armarten/hmc-cowBell-clinic/custom_emitter_team/matlab_data/arduino_plot_figs/03-24_coolterm_parallel_alicat_scatter_error_compare_fig_52.png

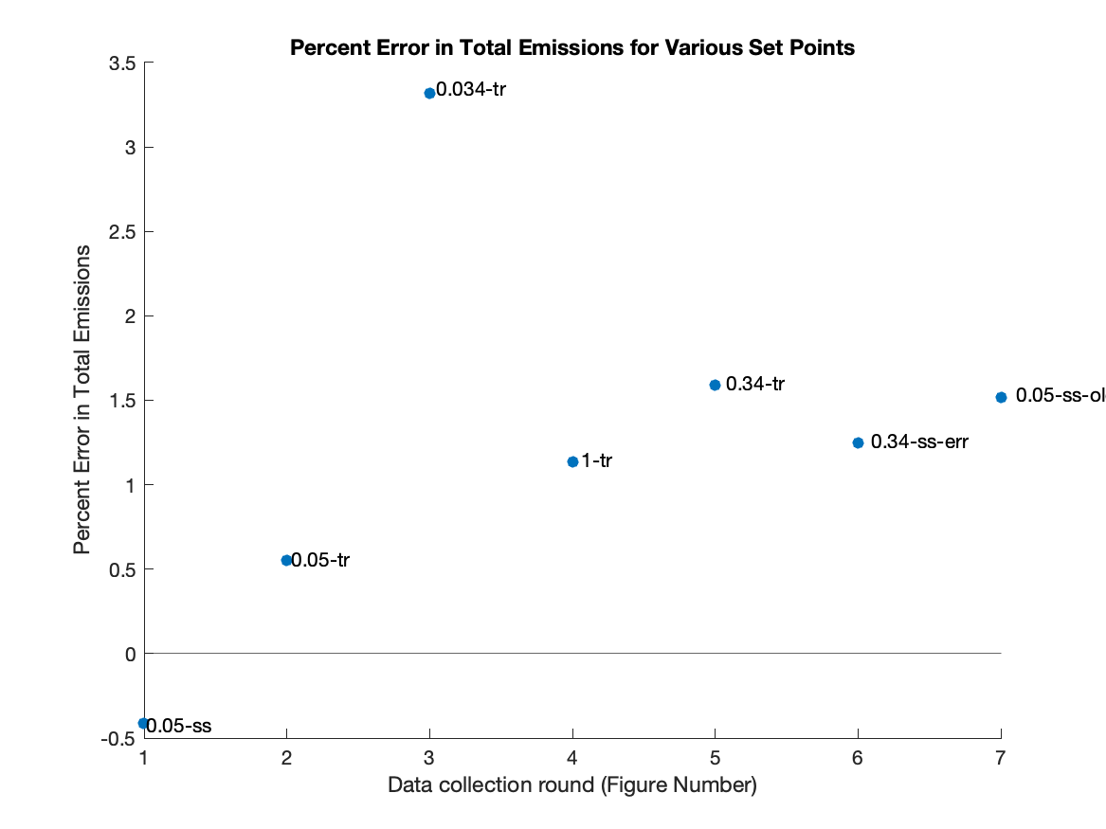
custom_emitter_team/matlab_data/arduino_plot_figs/03-24_coolterm_parallel_alicat_scatter_error_compare_fig_52.png
