armarten/hmc-cowBell-clinic/custom_emitter_team/matlab_data/arduino_plot_figs/04-23_cal_sensirion_leak.png

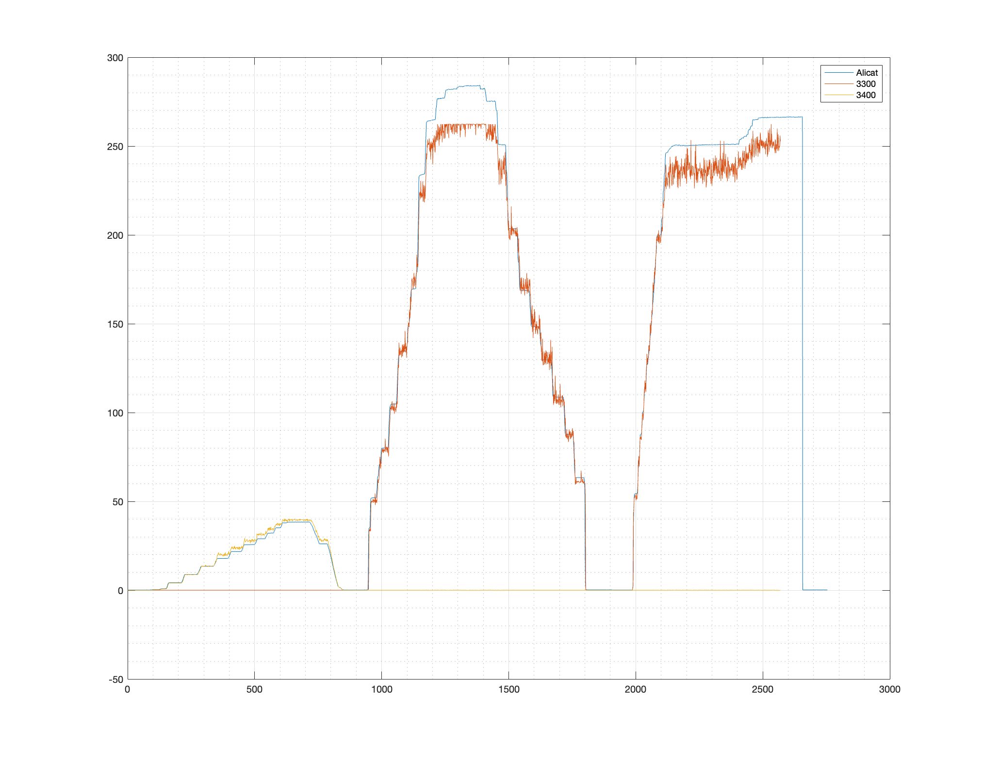
custom_emitter_team/matlab_data/arduino_plot_figs/04-23_cal_sensirion_leak.png
