armarten/hmc-cowBell-clinic/custom_emitter_team/matlab_data/arduino_plot_figs/07-Feb-2024-13-24-22_ppp_sweepppp_sweep_fig_30.png

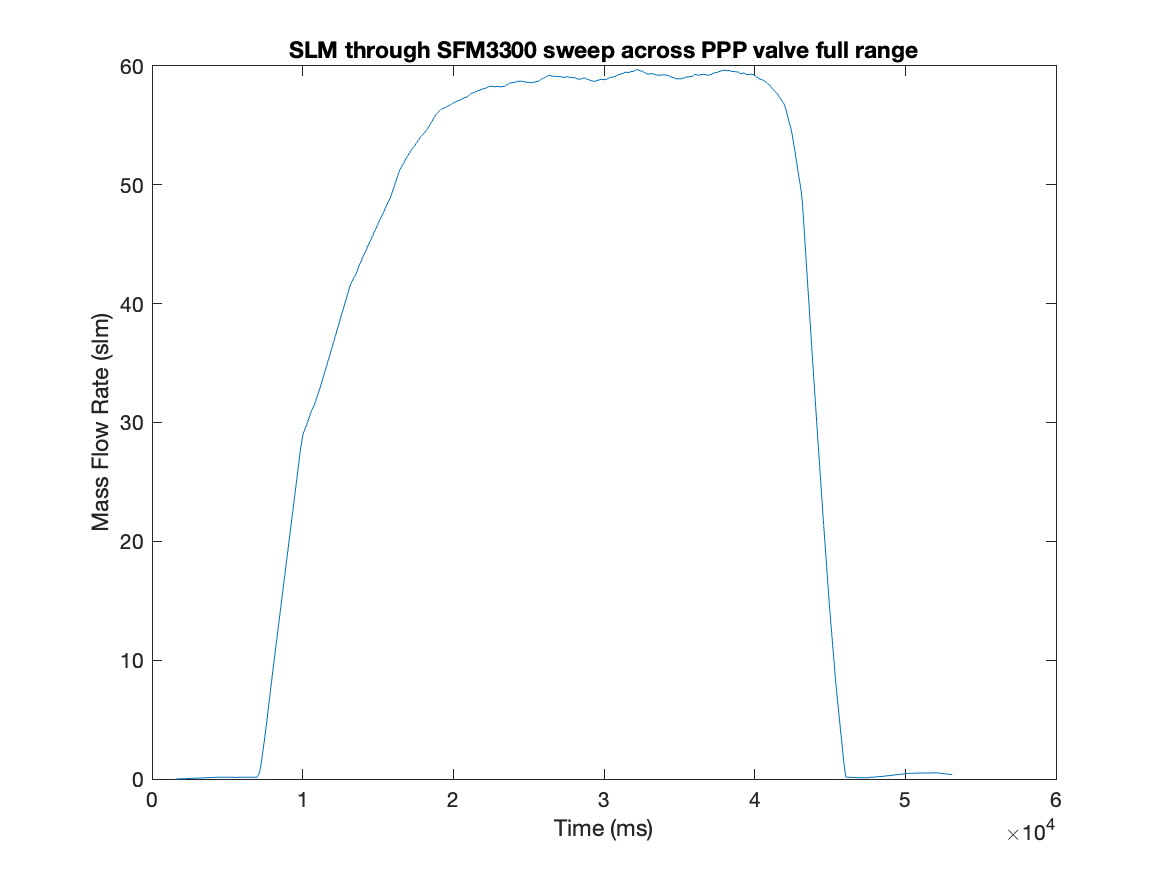
custom_emitter_team/matlab_data/arduino_plot_figs/07-Feb-2024-13-24-22_ppp_sweepppp_sweep_fig_30.png
