armarten/hmc-cowBell-clinic/custom_emitter_team/matlab_data/arduino_plot_figs/all_mag_poster.png

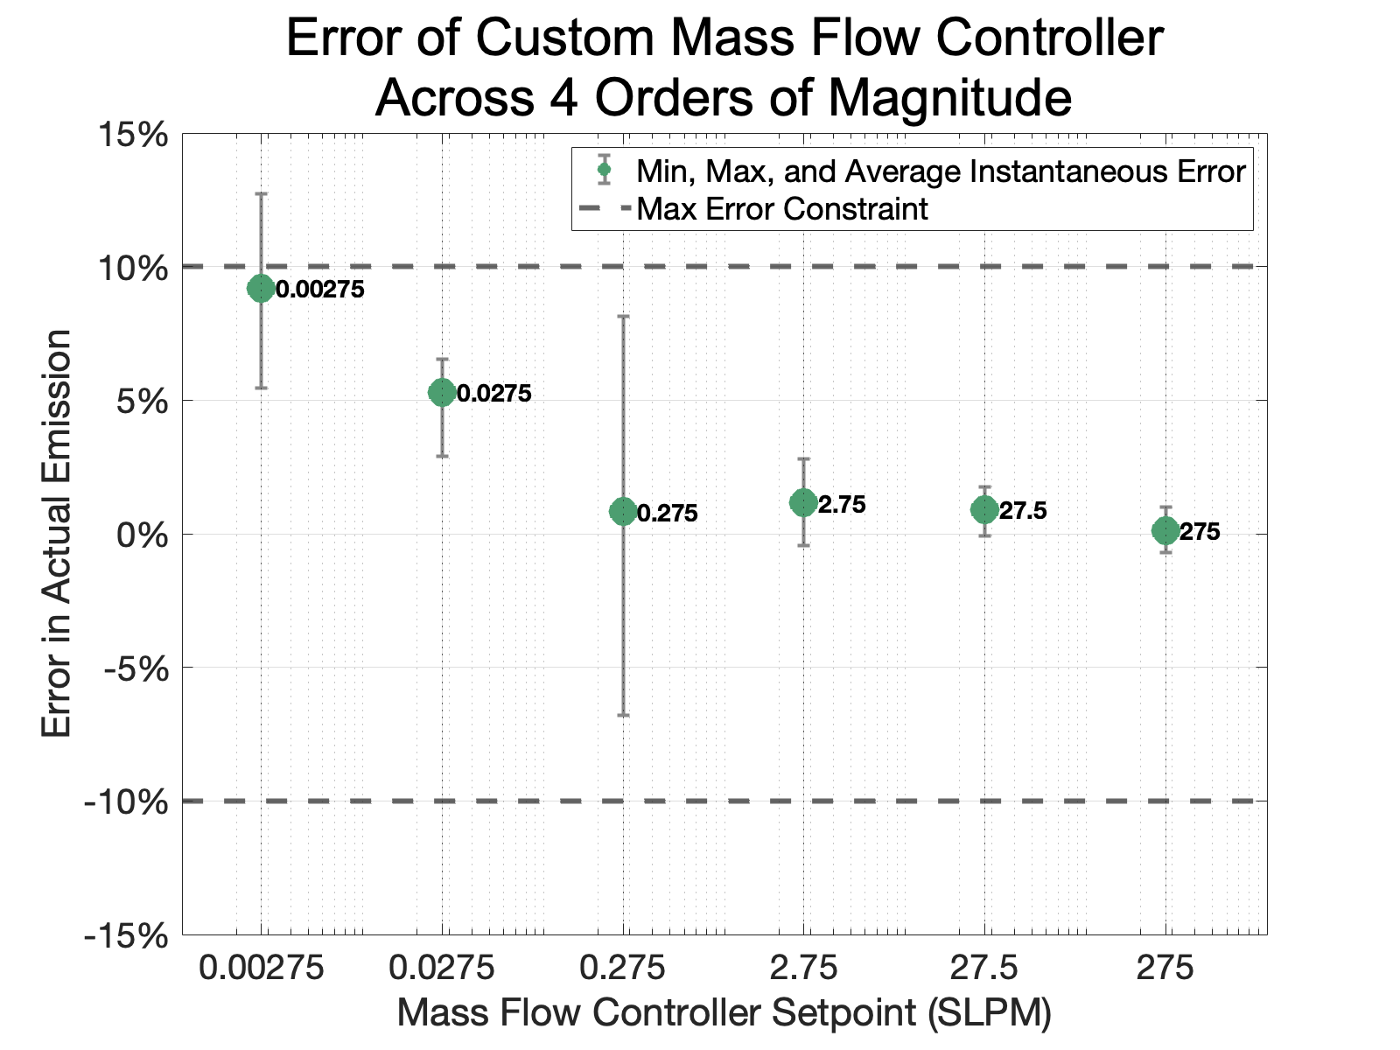
custom_emitter_team/matlab_data/arduino_plot_figs/all_mag_poster.png
