armarten/hmc-cowBell-clinic/custom_emitter_team/matlab_data/arduino_plot_figs/all_magnitudes_final_presentation.png

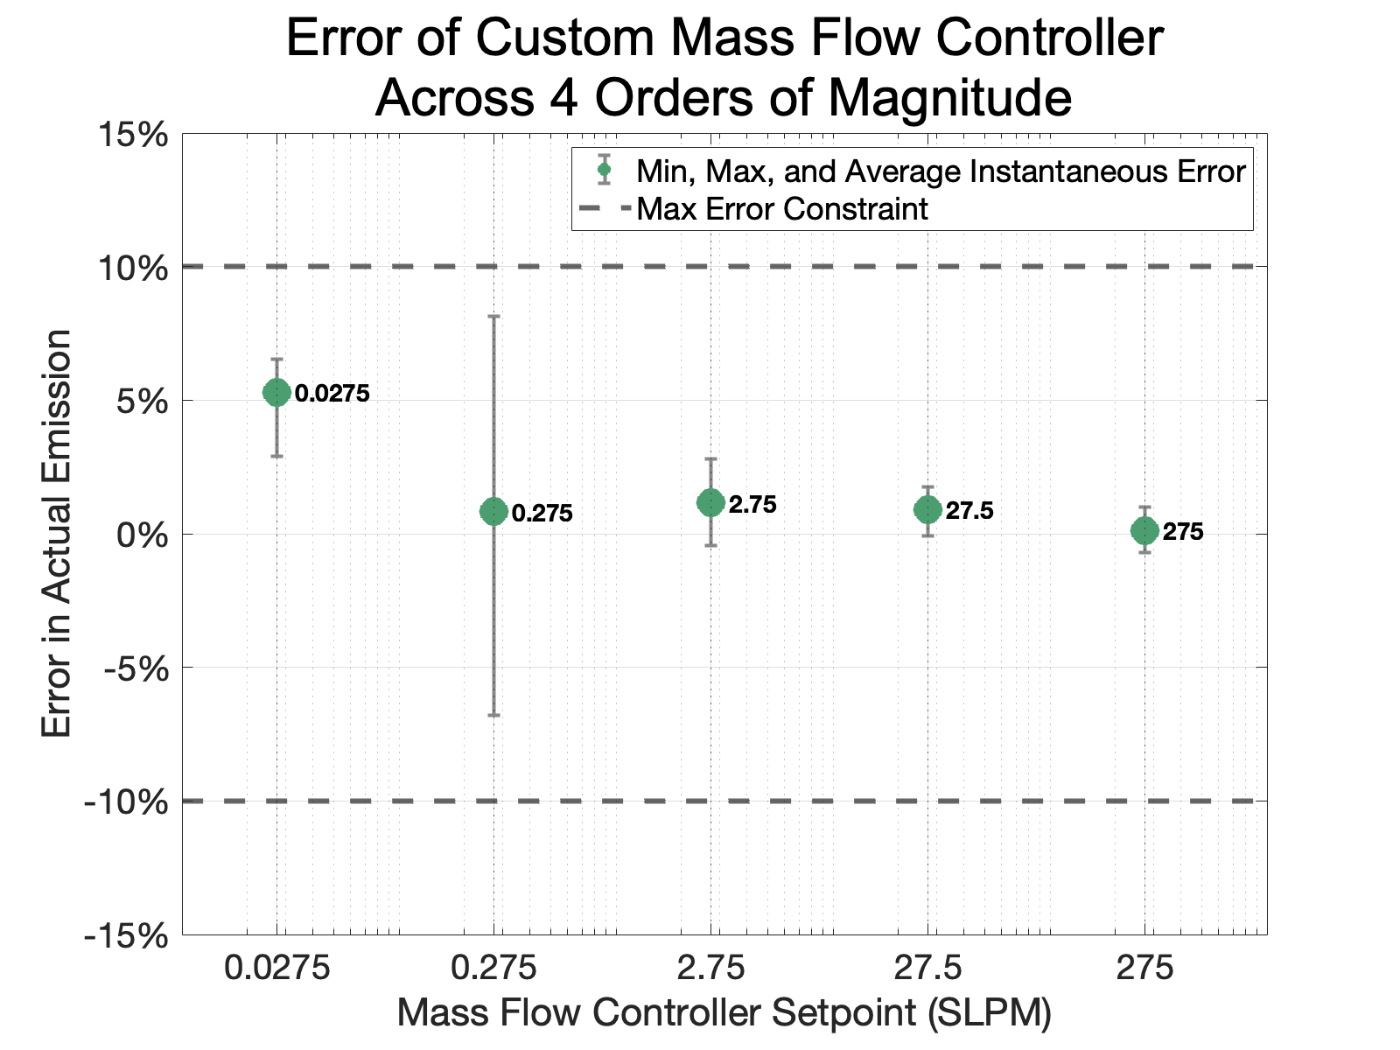
custom_emitter_team/matlab_data/arduino_plot_figs/all_magnitudes_final_presentation.png
