armarten/hmc-cowBell-clinic/custom_emitter_team/matlab_data/arduino_plot_figs/error_bars.png

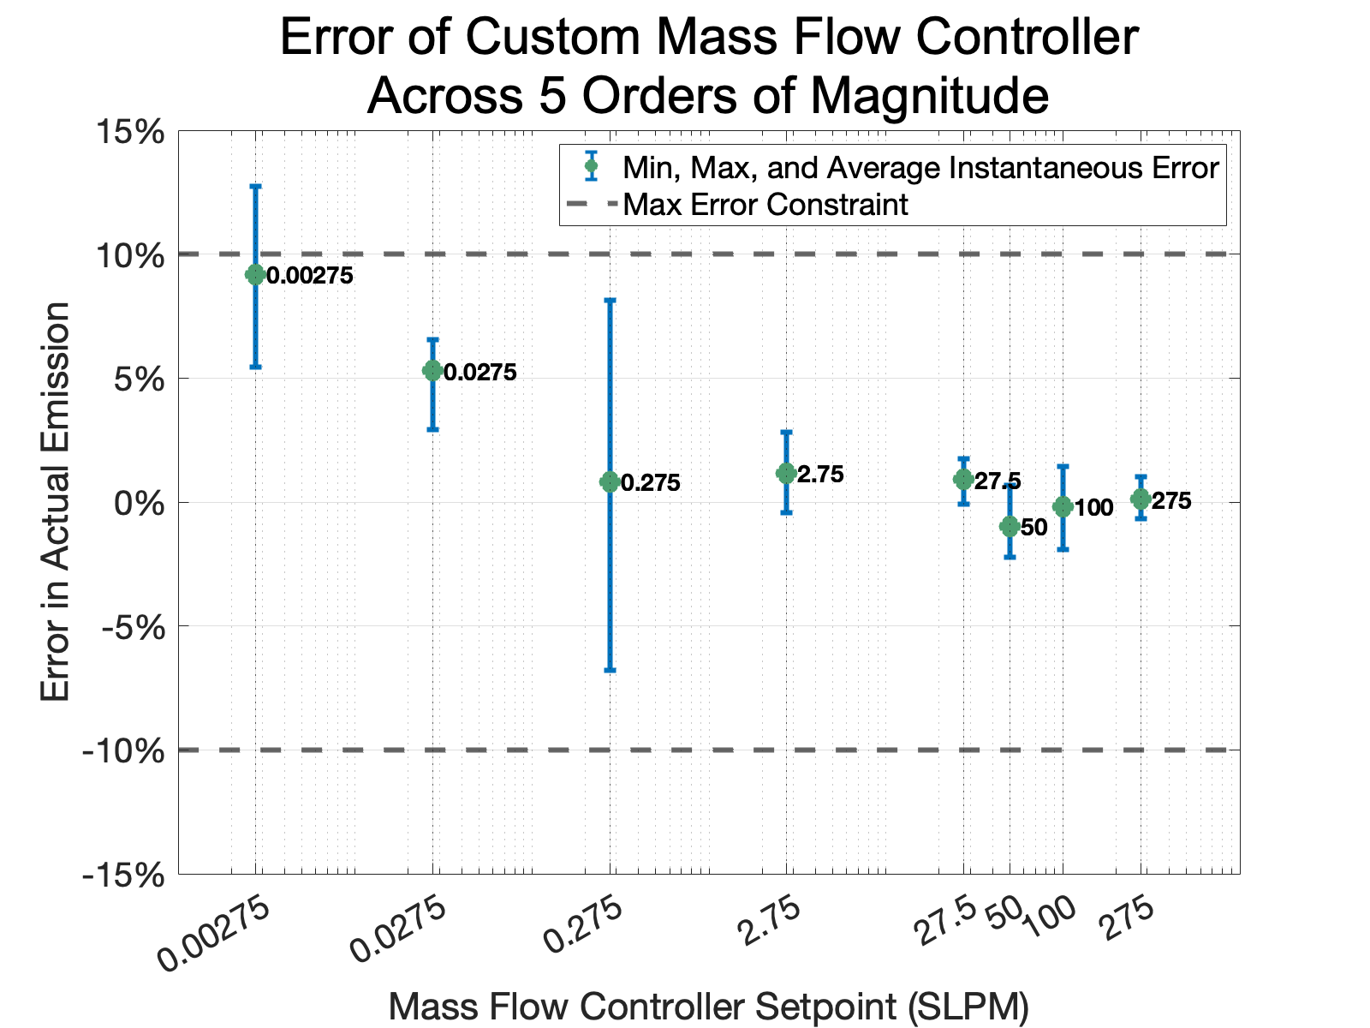
custom_emitter_team/matlab_data/arduino_plot_figs/error_bars.png
