armarten/hmc-cowBell-clinic/custom_emitter_team/matlab_data/arduino_plot_figs/investigate_100_260_offsets.png

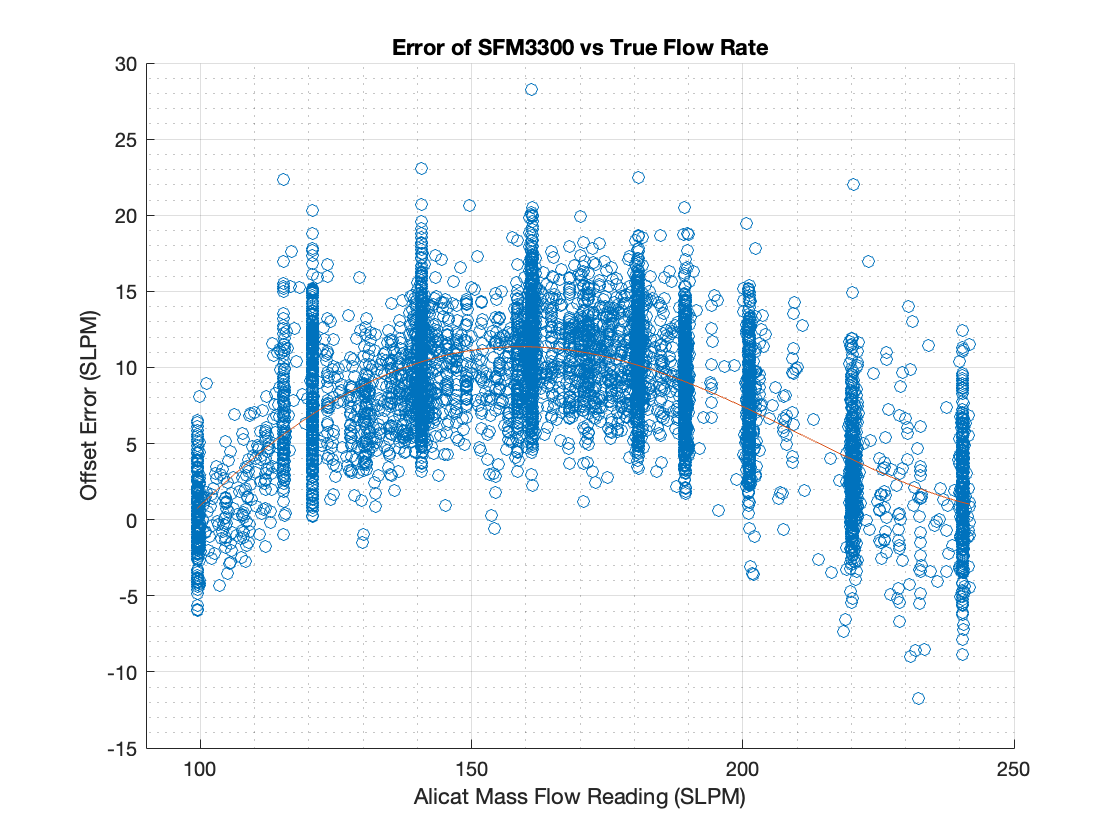
custom_emitter_team/matlab_data/arduino_plot_figs/investigate_100_260_offsets.png
