armarten/hmc-cowBell-clinic/custom_emitter_team/matlab_data/arduino_plot_figs/p control 3400 2_12_2024 - Sheet 4__fig_30.png

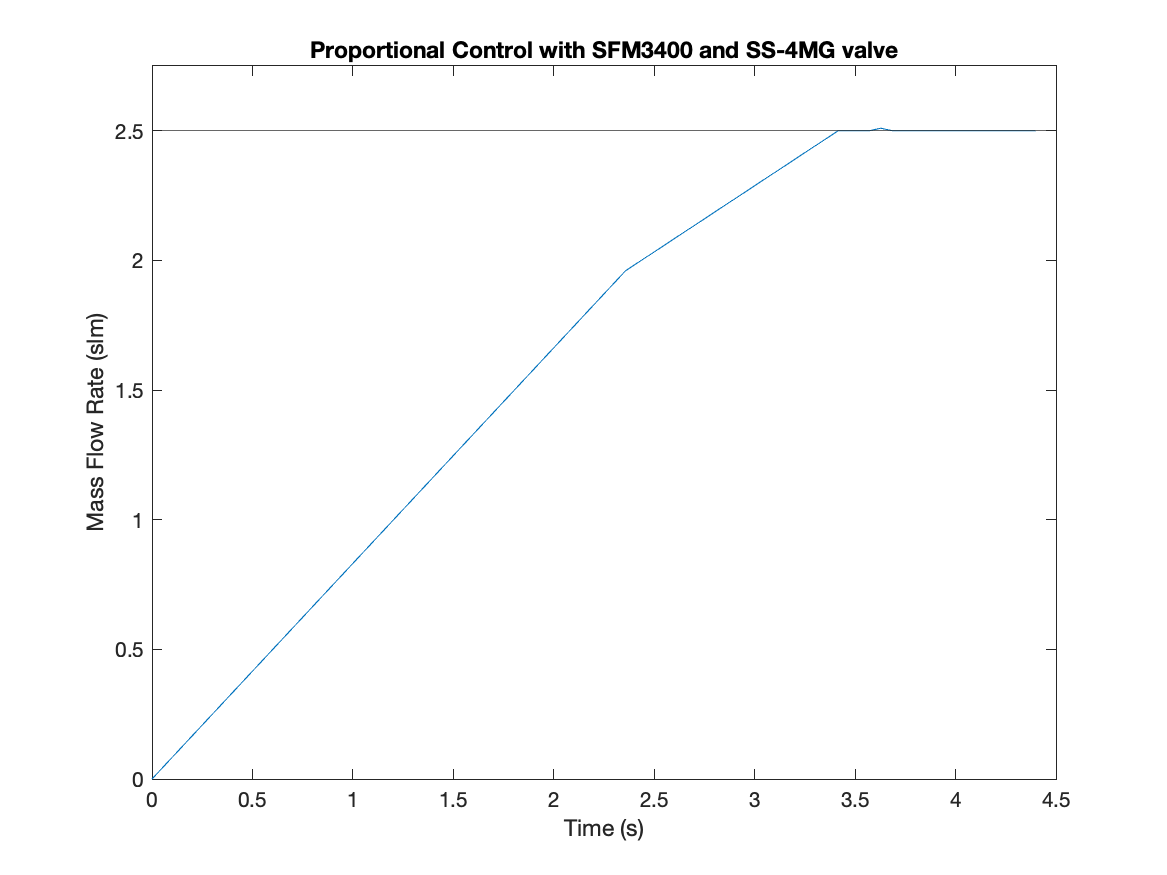
custom_emitter_team/matlab_data/arduino_plot_figs/p control 3400 2_12_2024 - Sheet 4__fig_30.png
