armarten/hmc-cowBell-clinic/custom_emitter_team/matlab_data/arduino_plot_figs/parallal_all_magnitudes_alicat__fig_50.png

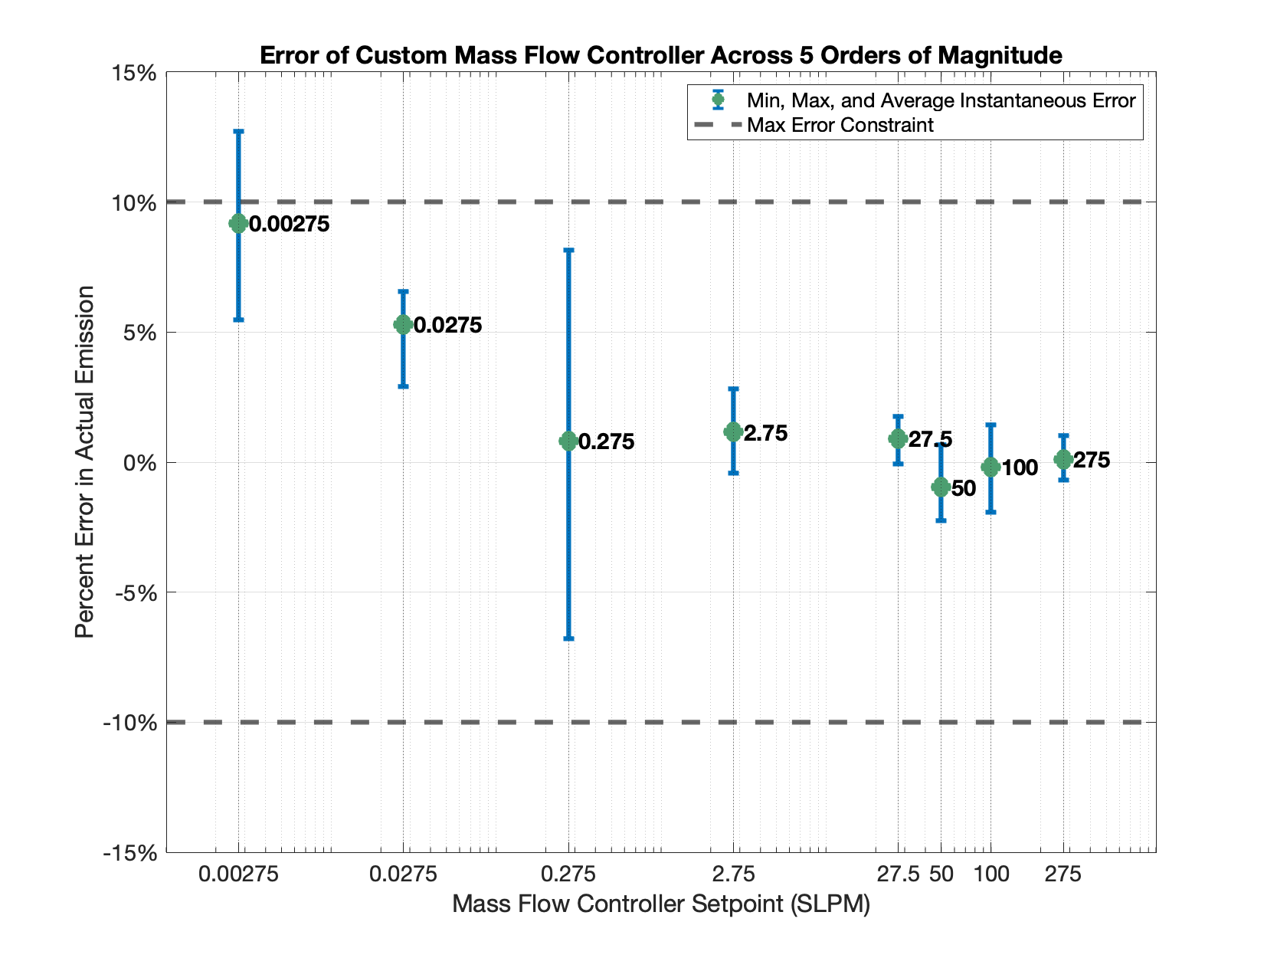
custom_emitter_team/matlab_data/arduino_plot_figs/parallal_all_magnitudes_alicat__fig_50.png
