armarten/hmc-cowBell-clinic/custom_emitter_team/matlab_data/arduino_plot_figs/parallel_flow.png

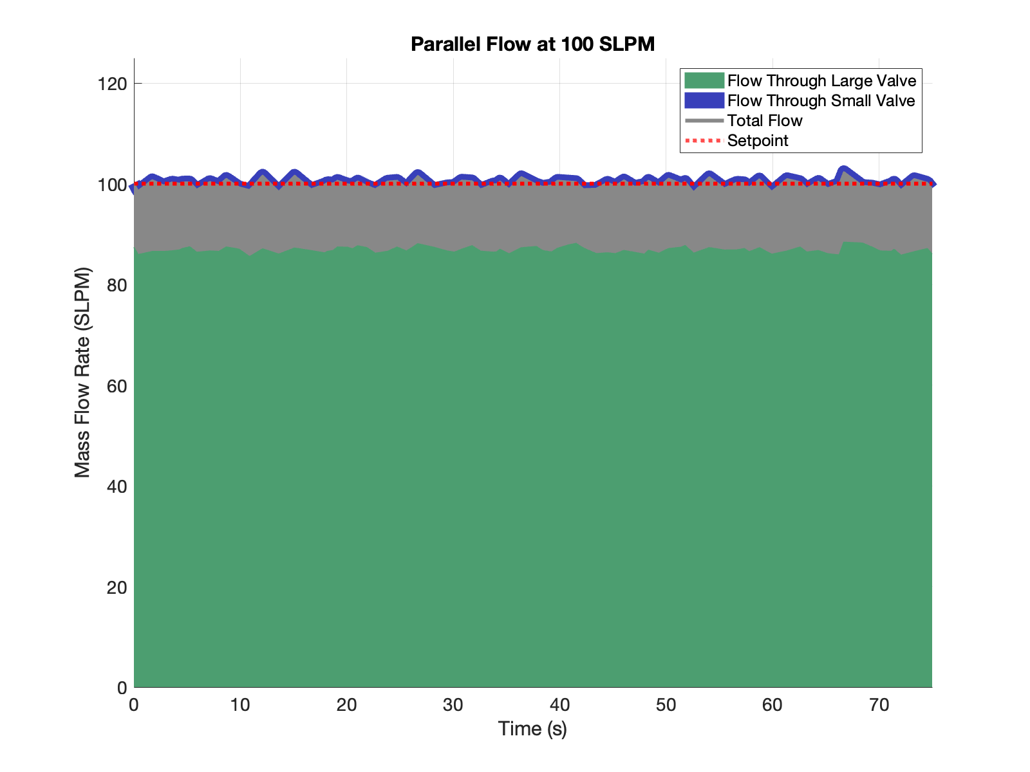
custom_emitter_team/matlab_data/arduino_plot_figs/parallel_flow.png
