armarten/hmc-cowBell-clinic/custom_emitter_team/matlab_data/arduino_plot_figs/sensirion_cal_fig_66.png

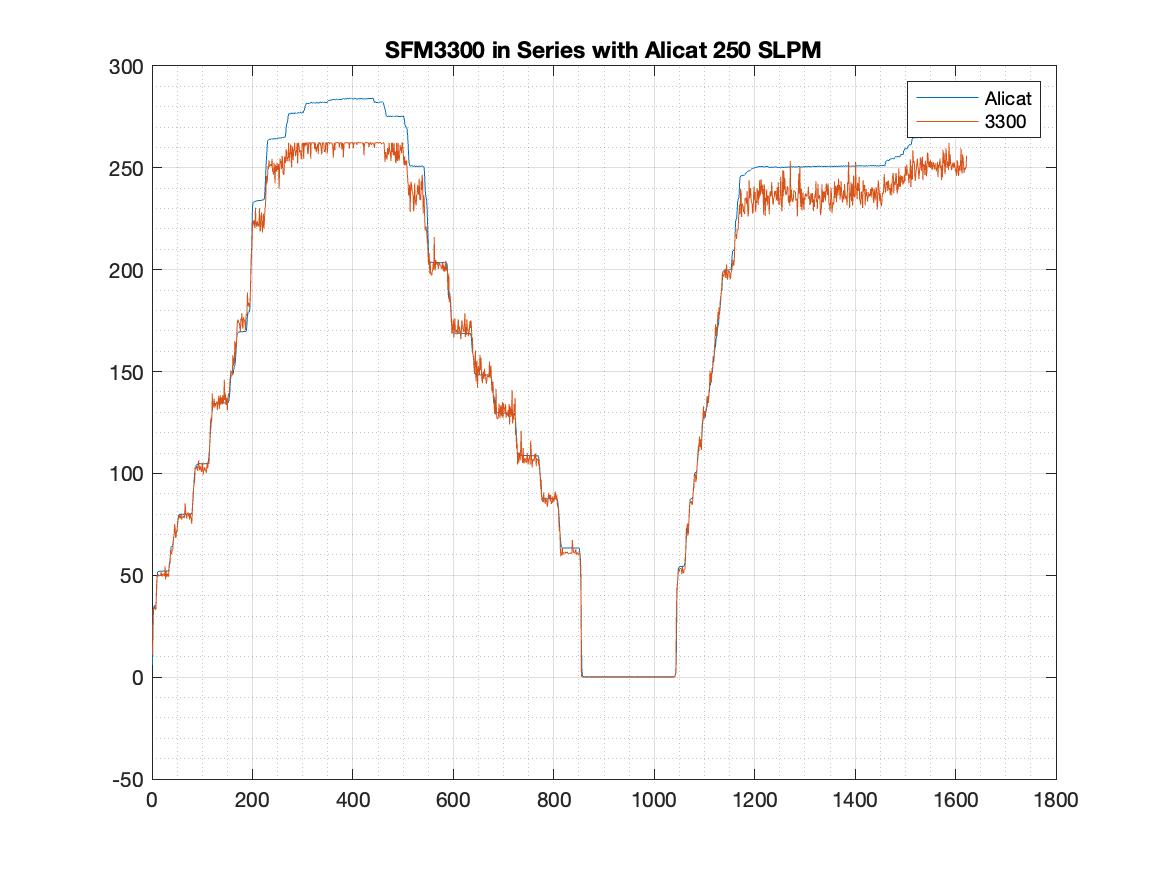
custom_emitter_team/matlab_data/arduino_plot_figs/sensirion_cal_fig_66.png
