armarten/hmc-cowBell-clinic/custom_emitter_team/matlab_data/arduino_plot_figs/ss_parallel.png

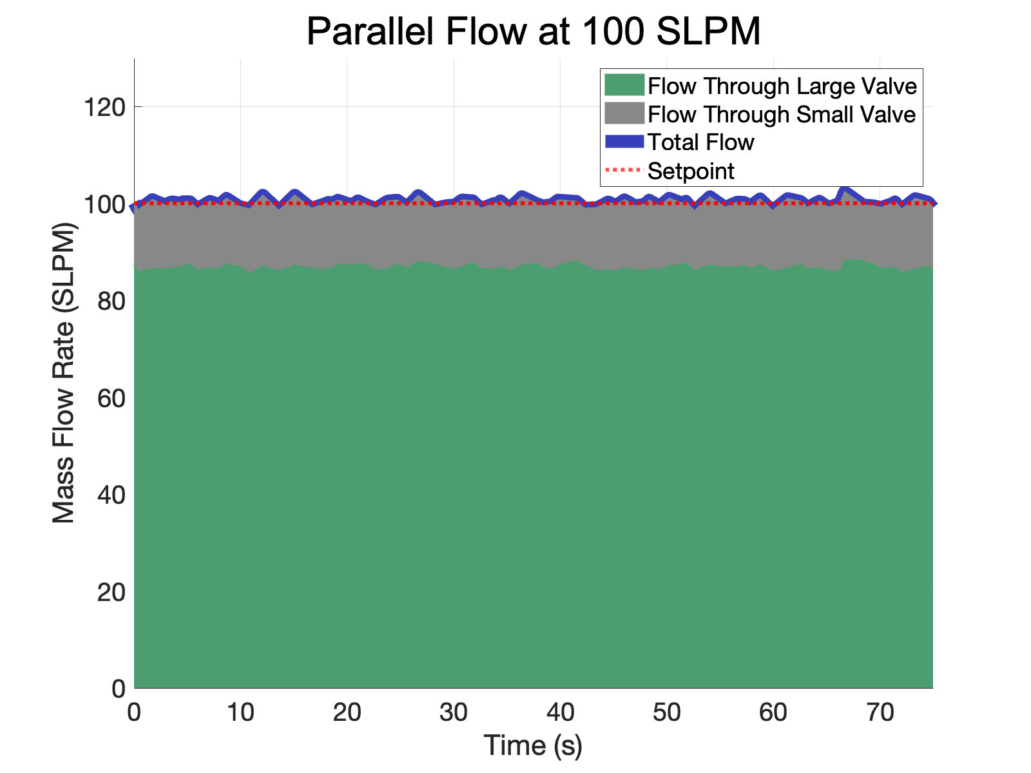
custom_emitter_team/matlab_data/arduino_plot_figs/ss_parallel.png
