armarten/hmc-cowBell-clinic/custom_emitter_team/matlab_data/arduino_plot_figs/sweep_final_report_figs/sensirion_cal_fig_20.png

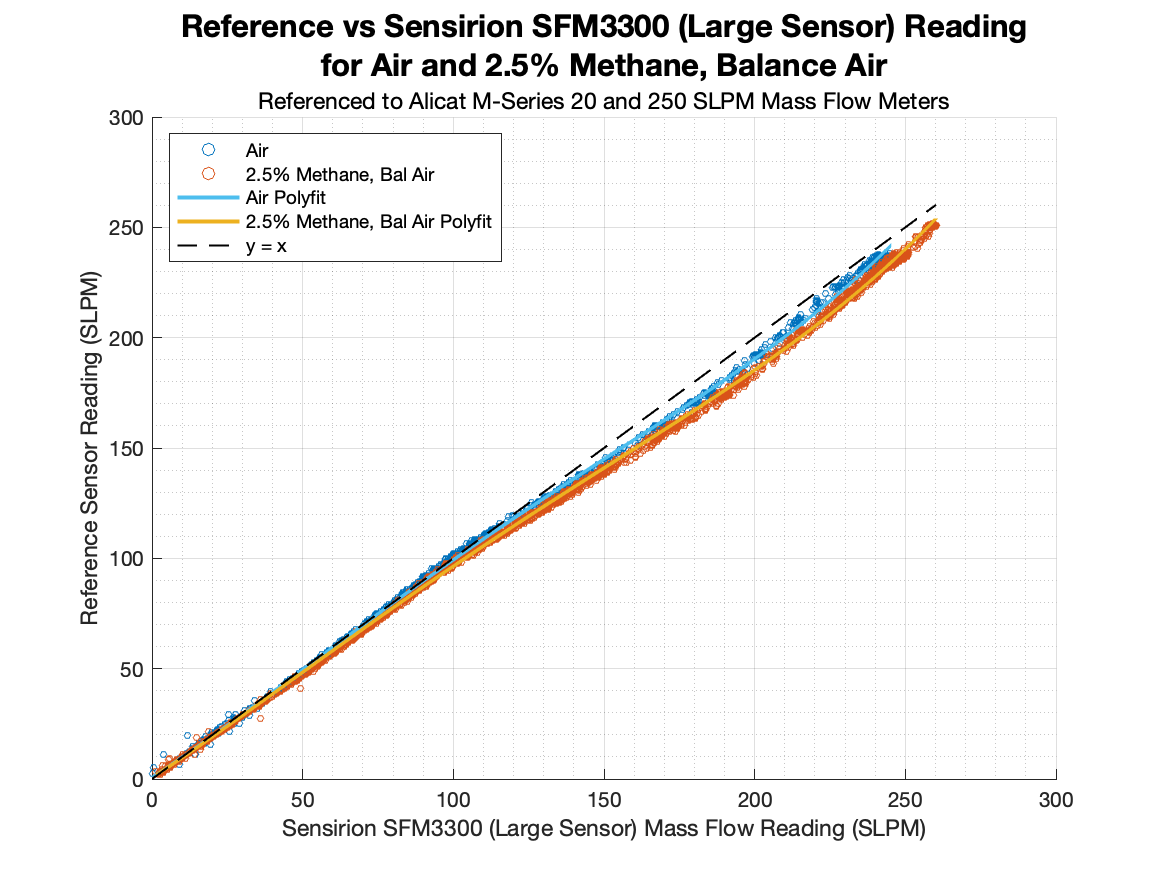
custom_emitter_team/matlab_data/arduino_plot_figs/sweep_final_report_figs/sensirion_cal_fig_20.png
