armarten/hmc-cowBell-clinic/custom_emitter_team/matlab_data/untitled.png

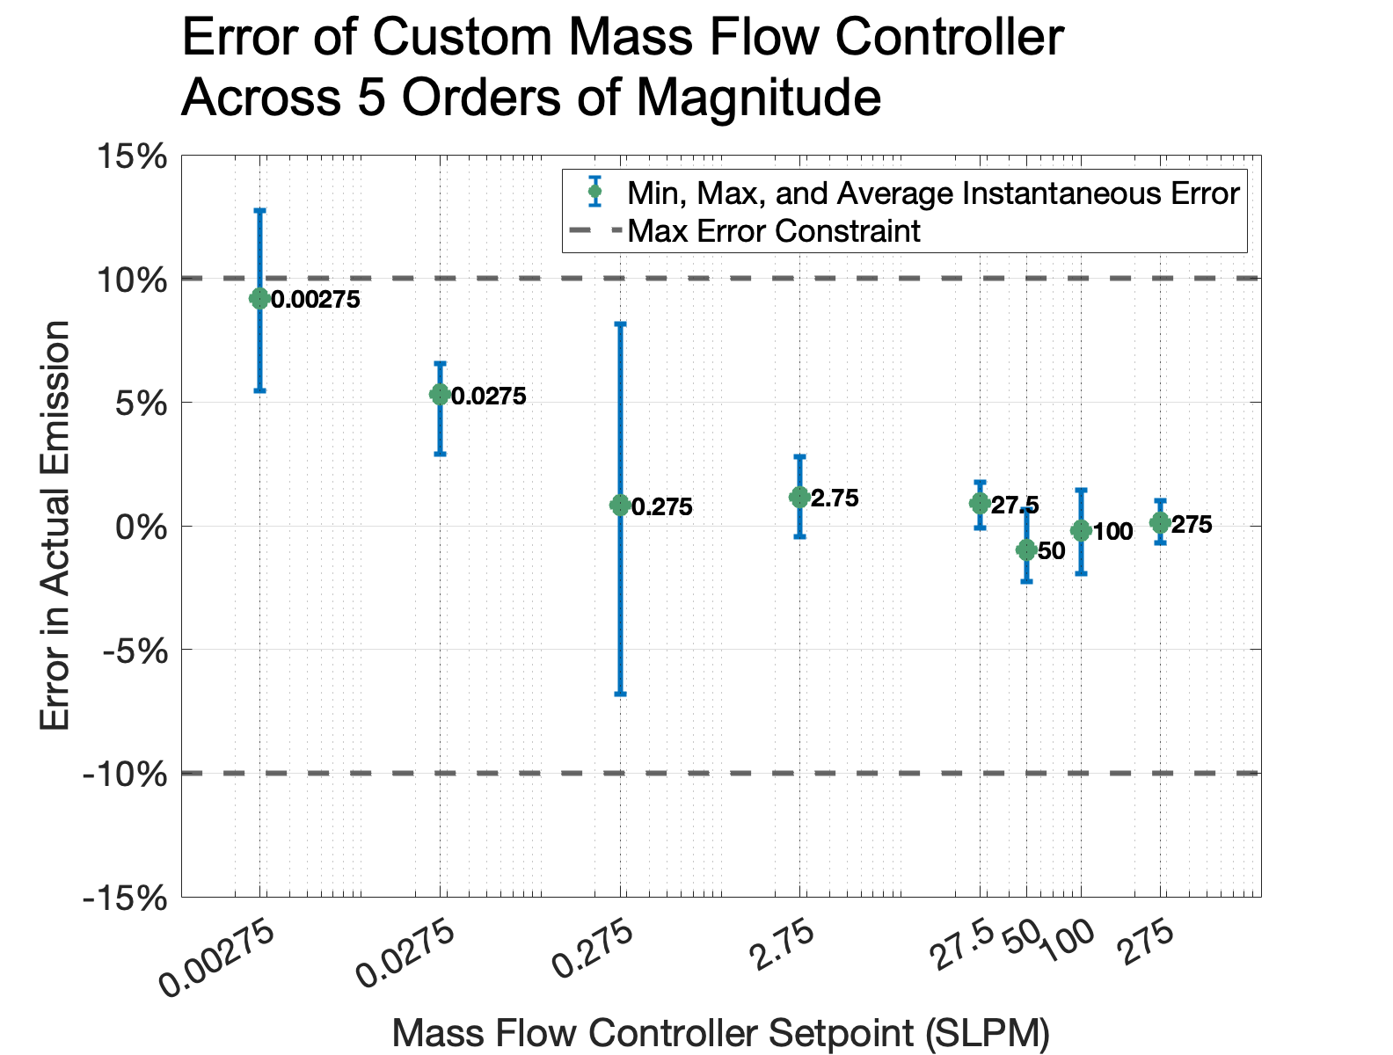
custom_emitter_team/matlab_data/untitled.png
