armarten/hmc-cowBell-clinic/custom_emitter_team/rasp_pi/plot_figs/2023_11_09__17_59_18__100_hz__1000_n__cal_fig_3.png

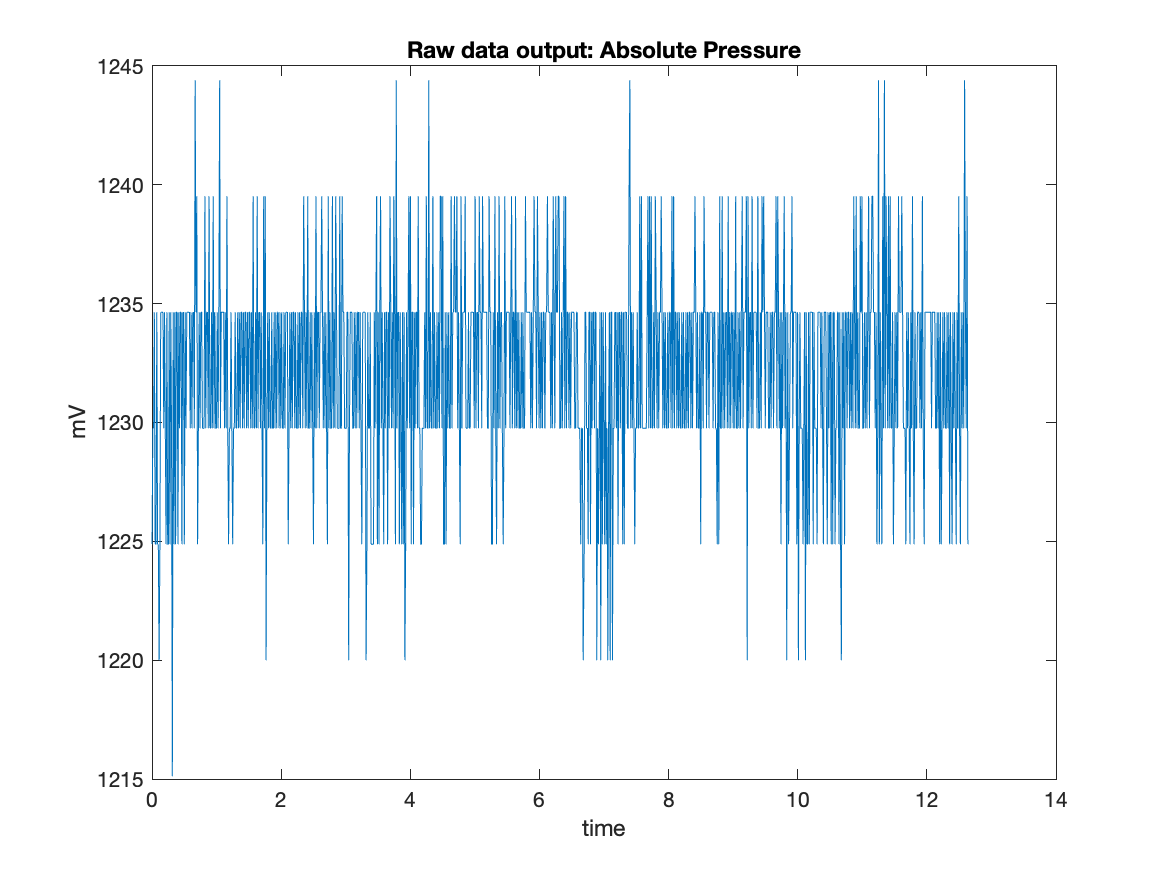
custom_emitter_team/rasp_pi/plot_figs/2023_11_09__17_59_18__100_hz__1000_n__cal_fig_3.png
