armarten/hmc-cowBell-clinic/custom_emitter_team/rasp_pi/plot_figs/2023_11_09__19_15_26__100_hz__10000_n__low_range_fig_20.png

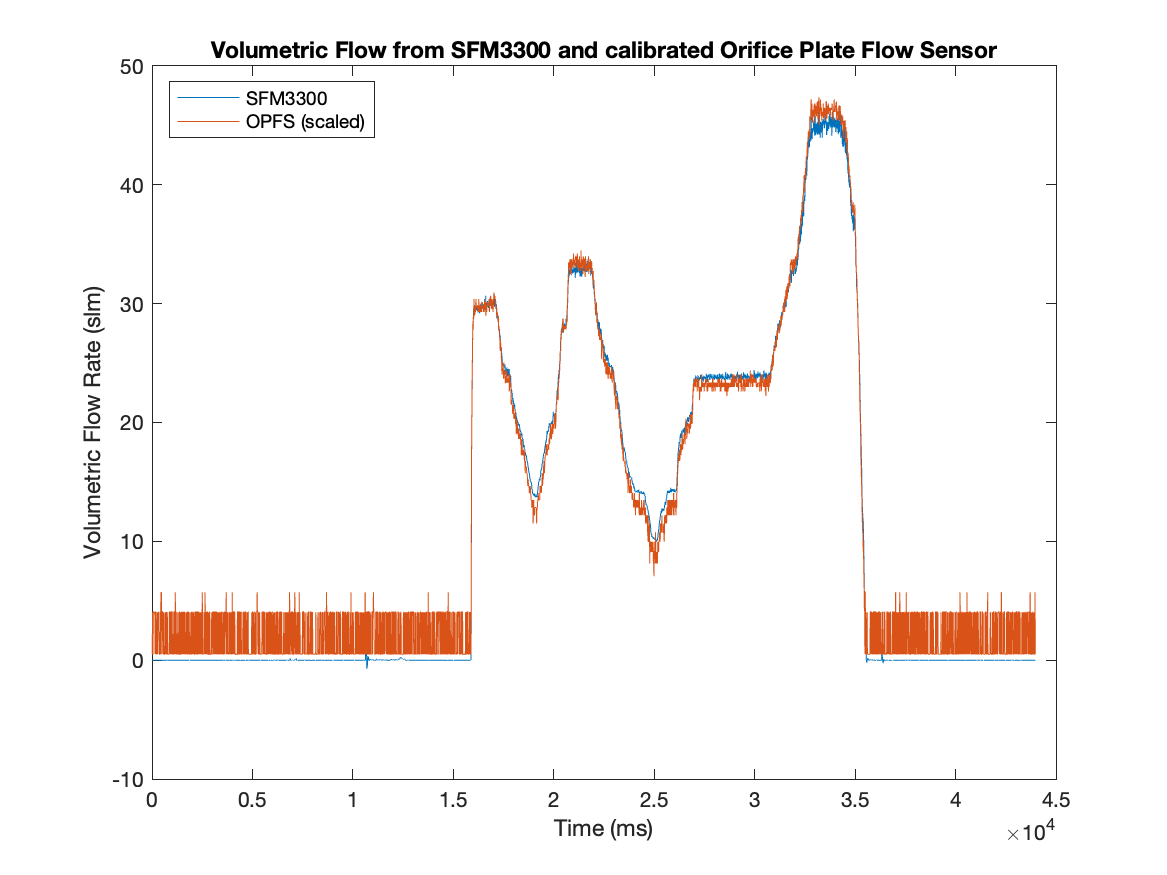
custom_emitter_team/rasp_pi/plot_figs/2023_11_09__19_15_26__100_hz__10000_n__low_range_fig_20.png
