armarten/hmc-cowBell-clinic/custom_emitter_team/rasp_pi/plot_figs/flow_run1_fig_10.png

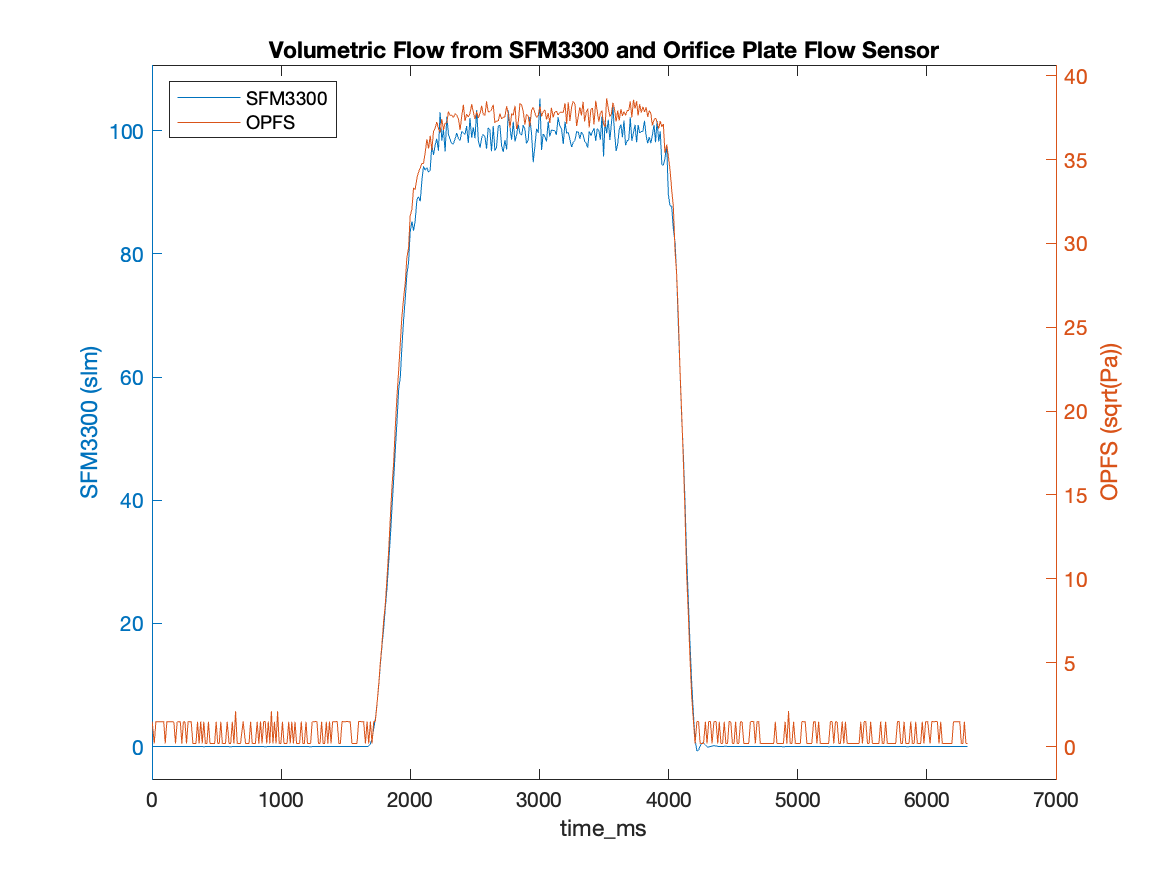
custom_emitter_team/rasp_pi/plot_figs/flow_run1_fig_10.png
