armarten/hmc-cowBell-clinic/custom_emitter_team/matlab_data/arduino_plot_figs/05-Feb-2024-21-27-39_test_zeroes5slm_step_fig_30.png

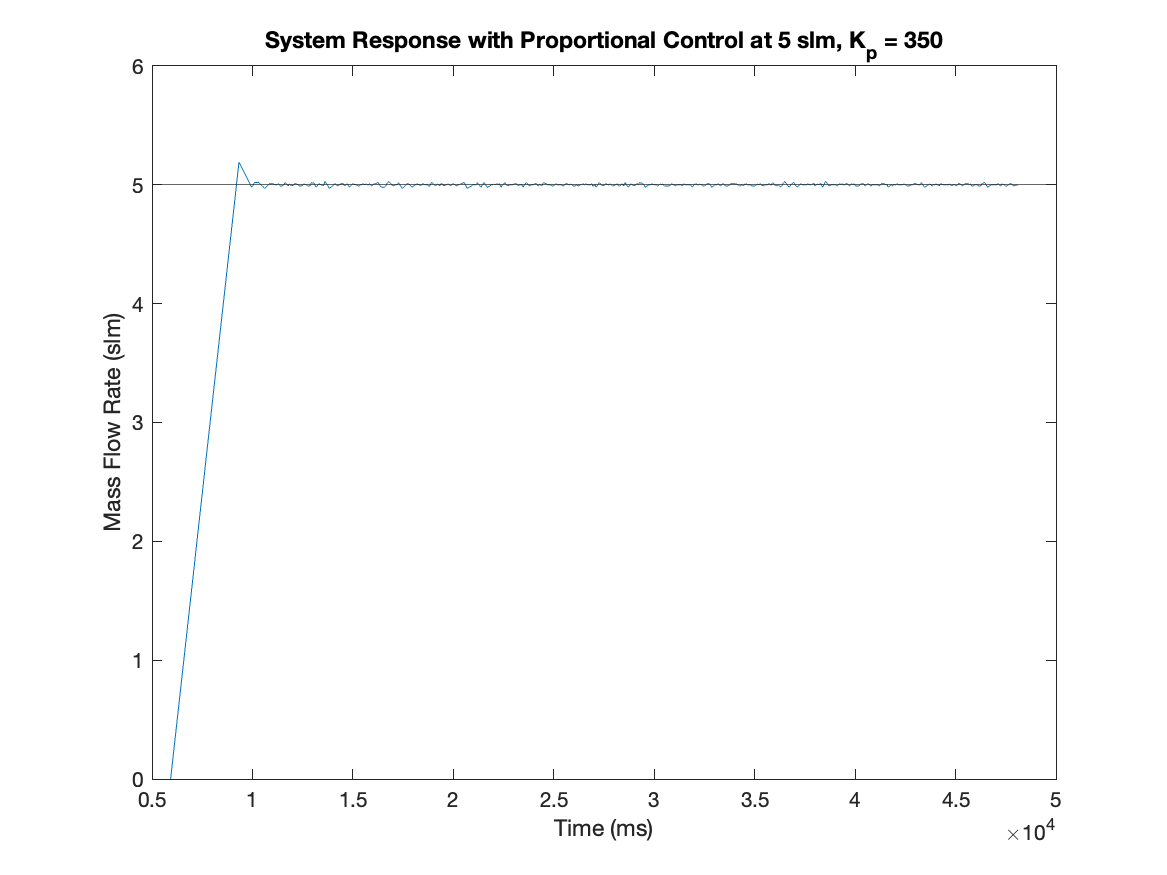
custom_emitter_team/matlab_data/arduino_plot_figs/05-Feb-2024-21-27-39_test_zeroes5slm_step_fig_30.png
