armarten/hmc-cowBell-clinic/custom_emitter_team/matlab_data/arduino_plot_figs/step_response.png

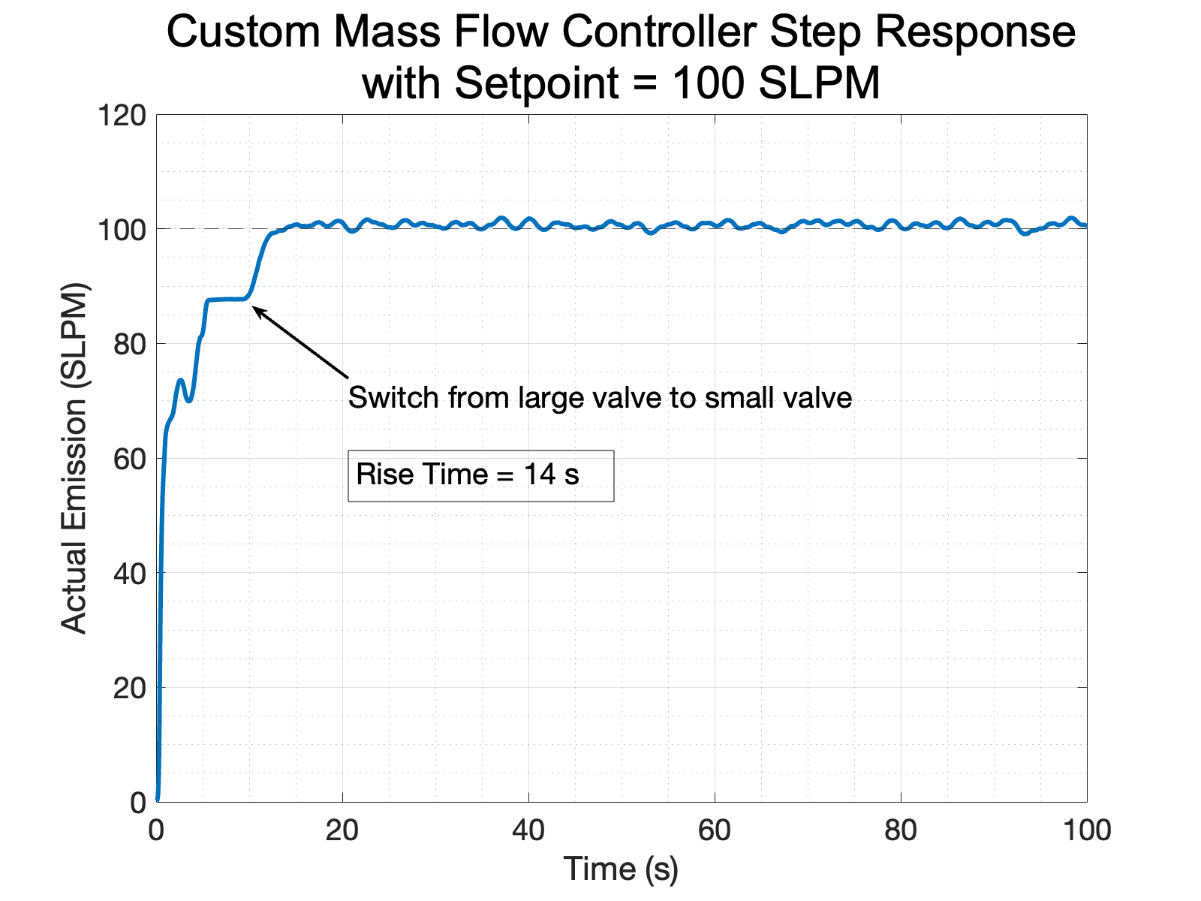
custom_emitter_team/matlab_data/arduino_plot_figs/step_response.png
