armarten/hmc-cowBell-clinic/custom_emitter_team/matlab_data/arduino_plot_figs/step_response_100_alicat250__fig_70.png

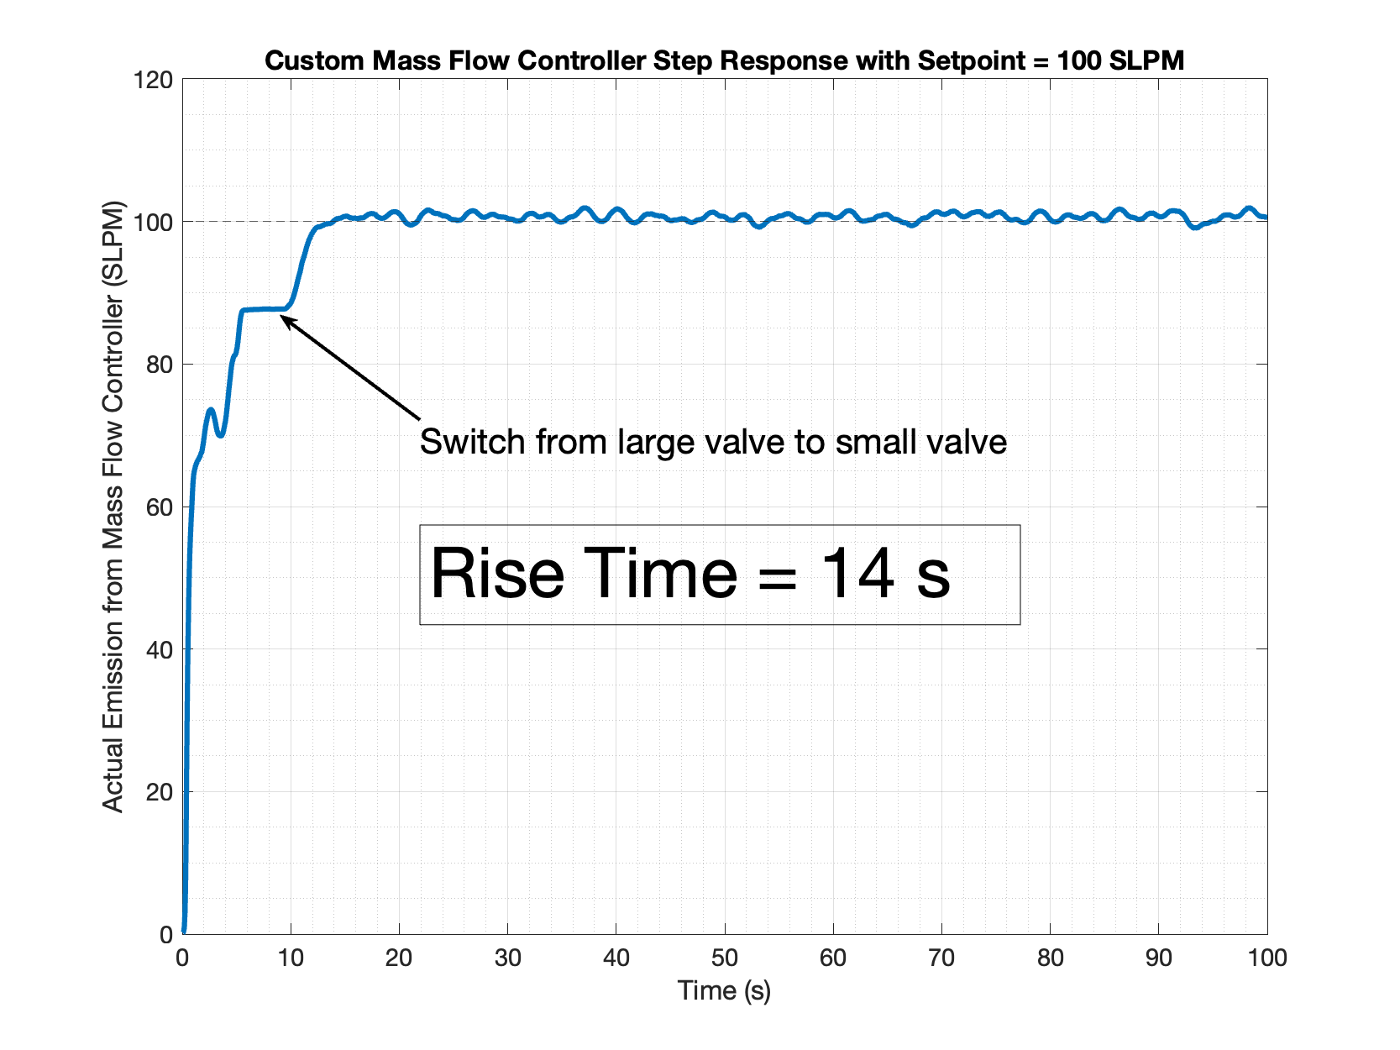
custom_emitter_team/matlab_data/arduino_plot_figs/step_response_100_alicat250__fig_70.png
