armarten/hmc-cowBell-clinic/custom_emitter_team/swagelok_brass_tests.rtf

-1-.00
50 , 389 , 0.00 , 0.00
4969 , 388 , 0.00 , 0.00
4996 , 387 , 0.00 , 0.00
5023 , 386 , 0.00 , 0.00
5050 , 385 , 0.00 , 0.00
50128035
128035
Sensor initialized!
data_begin
time_ms , raw_val , point_flow , avg_flow
1534 , 463 , 0.00 , 0.00
1561 , 460 , 0.00 , 0.00
1588 , 458 , 0.00 , 0.00
1615 , 456 , 0.03 , 0.00
1642 , 455 , 0.00 , 0.00
1670 , 453 , 0.03 , 0.00
1696 , 451 , 0.00 , 0.00
1723 , 449 , 0.00 , 0.00
1751 , 447 , 0.00 , 0.00
1777 , 446 , 0.00 , 0.00
1805 , 444 , 0.00 , 0.00
1831 , 442 , 0.00 , 0.00
1858 , 440 , 0.00 , 0.00
1886 , 438 , 0.00 , 0.00
1912 , 438 , 0.00 , 0.00
1940 , 447 , 0.00 , 0.00
1967 , 447 , 0.00 , 0.00
1993 , 446 , 0.00 , 0.00
2021 , 445 , 0.00 , 0.00
2048 , 444 , 0.00 , 0.00
2075 , 443 , 0.00 , 0.00
2102 , 441 , 0.00 , 0.00
2128 , 440 , 0.00 , 0.00
2156 , 438 , 0.00 , 0.00
2183 , 437 , 0.00 , 0.00
2210 , 435 , 0.00 , 0.00
2237 , 434 , 0.00 , 0.00
2265 , 432 , 0.00 , 0.00
2291 , 431 , 0.00 , 0.00
2318 , 428 , 0.00 , 0.00
2345 , 420 , 0.00 , 0.00
2372 , 414 , 0.00 , 0.00
2400 , 410 , 0.00 , 0.00
2426 , 408 , 0.00 , 0.00
2453 , 406 , 0.00 , 0.00
2481 , 404 , 0.00 , 0.00
2507 , 407 , 0.00 , 0.00
2535 , 414 , 0.00 , 0.00
2562 , 411 , 0.00 , 0.00
2588 , 407 , 0.00 , 0.00
2616 , 403 , 0.00 , 0.00
2642 , 396 , 0.00 , 0.00
2670 , 394 , 0.00 , 0.00
2697 , 392 , 0.03 , 0.00
2723 , 390 , 0.00 , 0.00
2751 , 388 , 0.00 , 0.00
2778 , 388 , 0.00 , 0.00
2805 , 386 , 0.00 , 0.00
2832 , 385 , 0.00 , 0.00
2859 , 385 , 0.00 , 0.00
2886 , 384 , 0.00 , 0.00
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
216471 , 251 , 24.63 , 24.61
216502 , 251 , 24.43 , 24.61
216534 , 251 , 24.73 , 24.61
216564 , 251 , 25.23 , 24.62
216596 , 251 , 24.63 , 24.62
216627 , 251 , 24.60 , 24.62
216658 , 251 , 24.47 , 24.62
216689 , 251 , 24.93 , 24.63
216721 , 251 , 24.50 , 24.61
216752 , 251 , 24.77 , 24.62
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
