armarten/hmc-cowBell-clinic/custom_emitter_team/matlab_data/arduino_plot_figs/03-24_coolterm_parallel_alicat_first_parallel_flow_test_fig_2.png

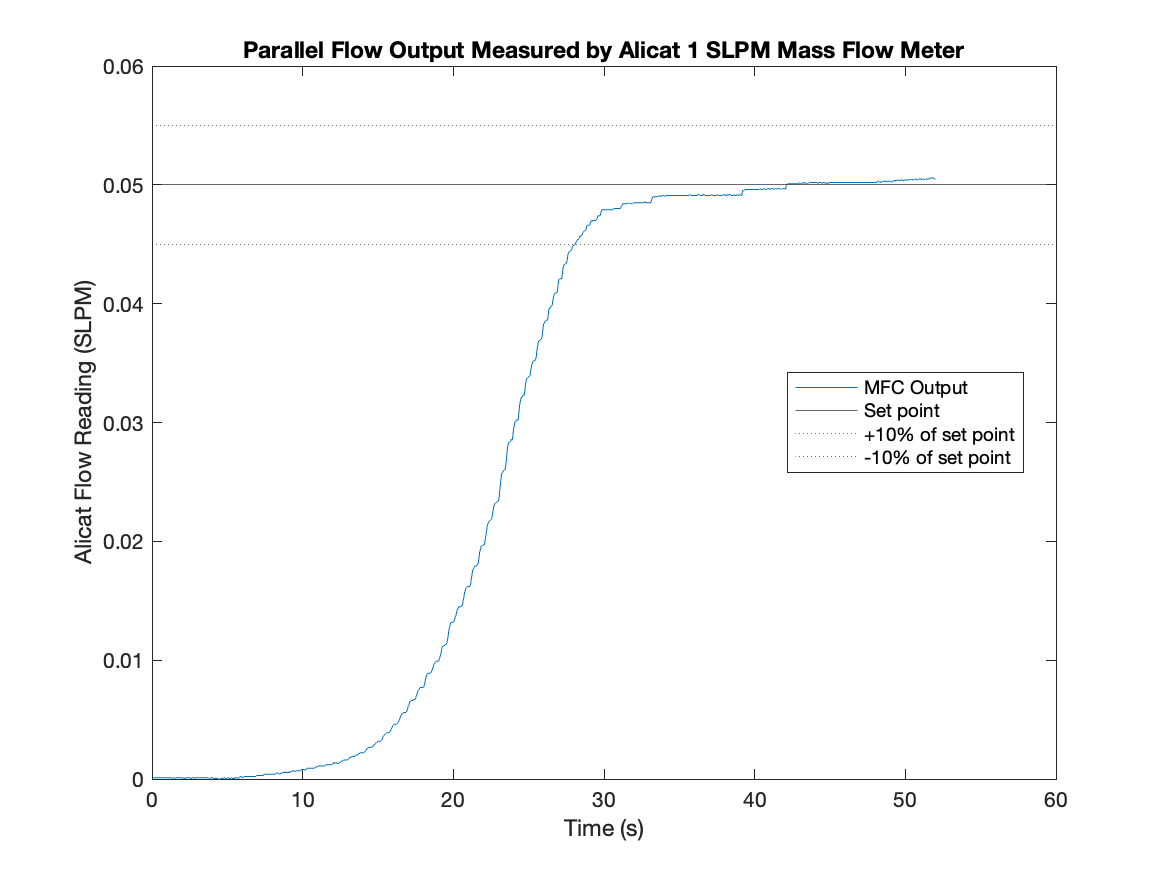
custom_emitter_team/matlab_data/arduino_plot_figs/03-24_coolterm_parallel_alicat_first_parallel_flow_test_fig_2.png
