armarten/hmc-cowBell-clinic/custom_emitter_team/matlab_data/arduino_plot_figs/21-Mar-2024-01-23-20_parallel_test__fig_44.png

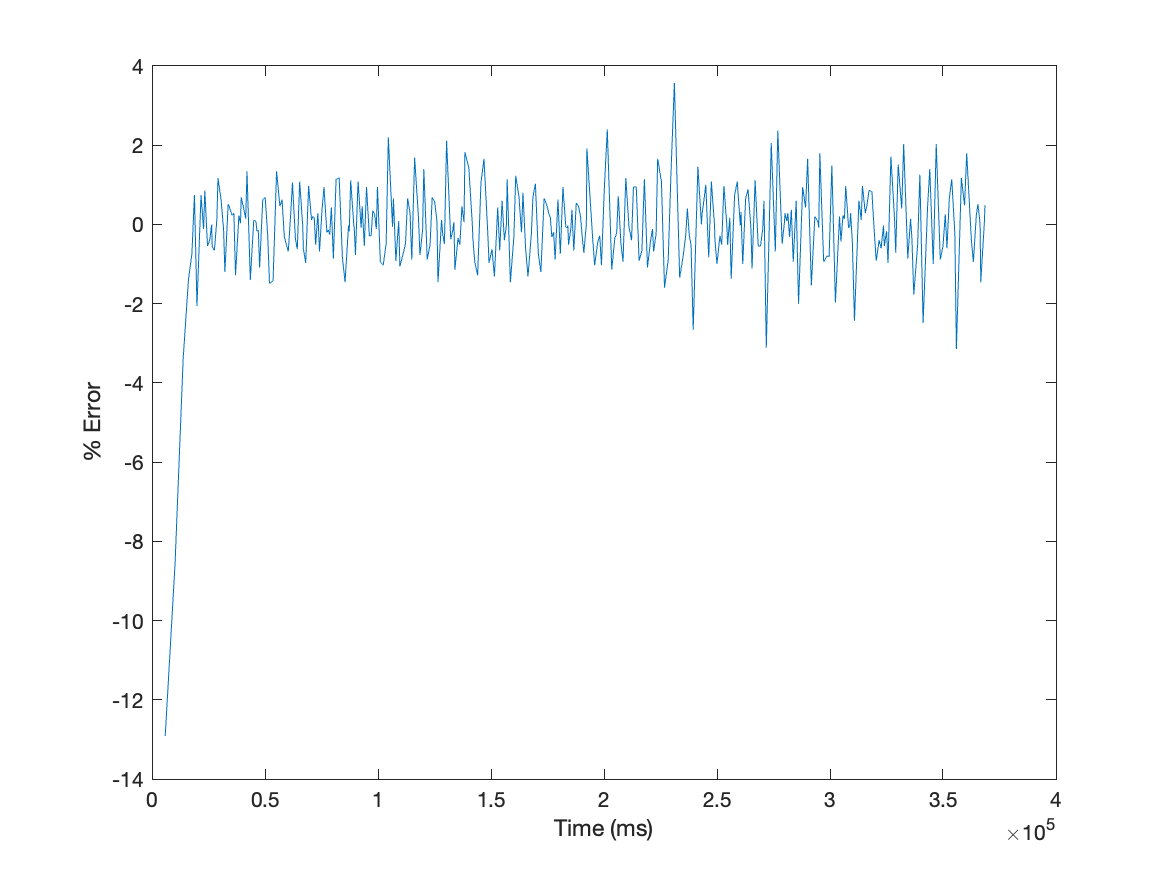
custom_emitter_team/matlab_data/arduino_plot_figs/21-Mar-2024-01-23-20_parallel_test__fig_44.png
