armarten/hmc-cowBell-clinic/custom_emitter_team/matlab_data/arduino_plot_figs/Custom Emitter Characterization and Calibration - Comparable MFCs__fig_30.png

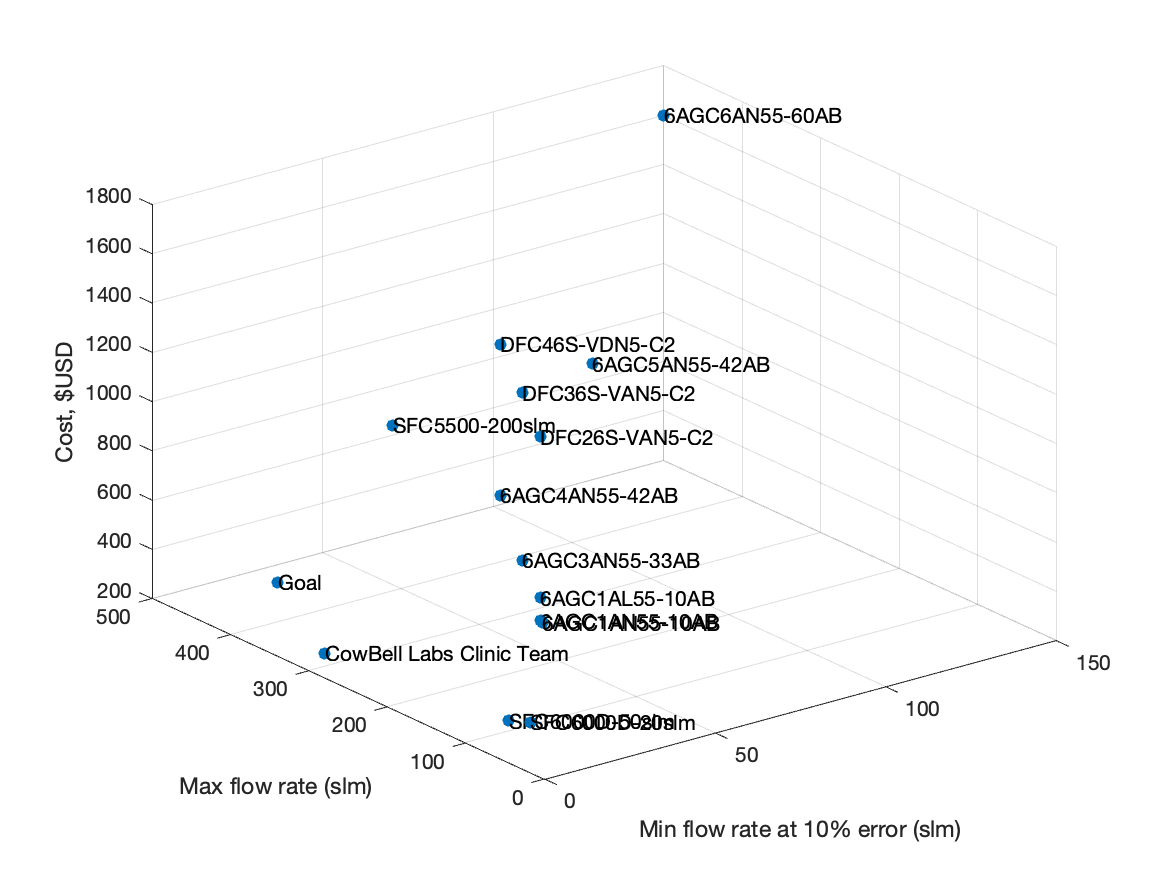
custom_emitter_team/matlab_data/arduino_plot_figs/Custom Emitter Characterization and Calibration - Comparable MFCs__fig_30.png
