armarten/hmc-cowBell-clinic/custom_emitter_team/rasp_pi/plot_figs/2023_11_28__16_25_39__100_hz__100_n__samp_rate_checksamp_rate_test_fig_34.png

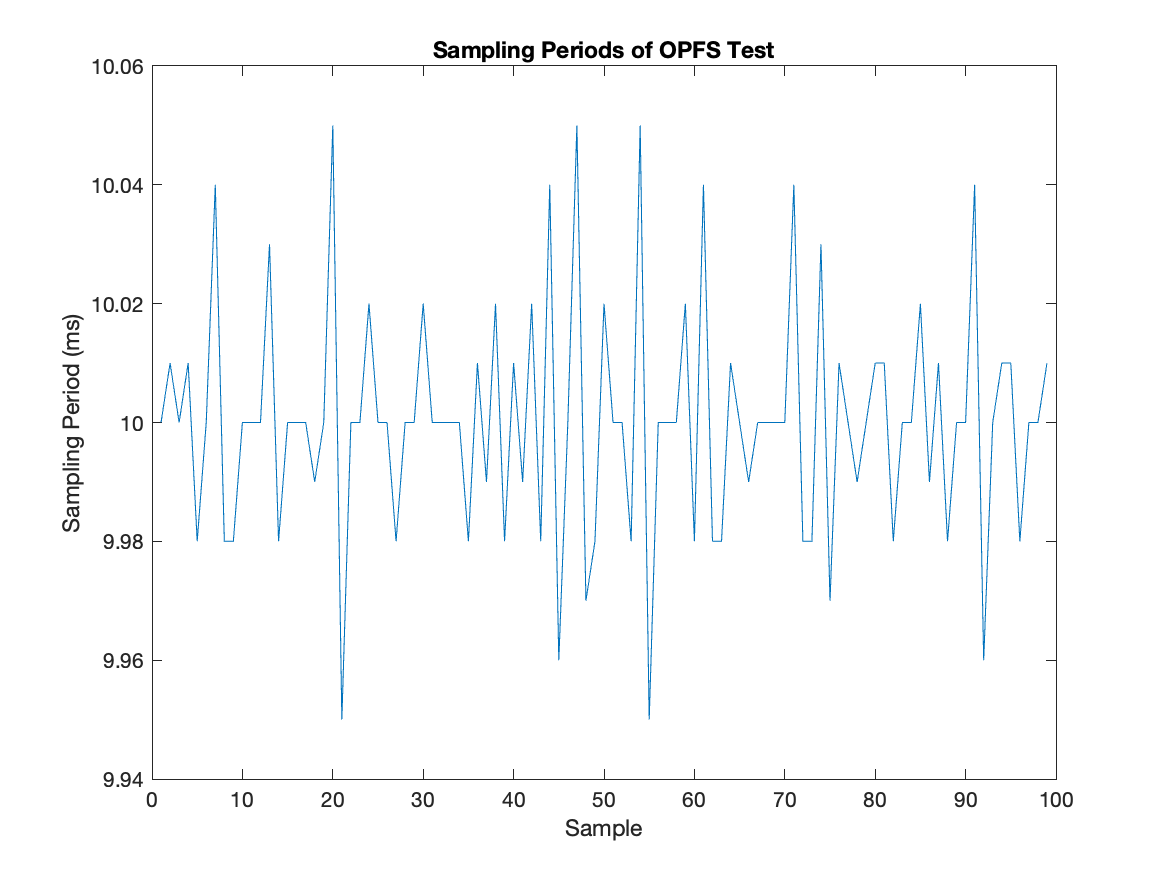
custom_emitter_team/rasp_pi/plot_figs/2023_11_28__16_25_39__100_hz__100_n__samp_rate_checksamp_rate_test_fig_34.png
