armarten/hmc-cowBell-clinic/allieSci50_wifi/led_wifi_input/src/main.cpp

/**
 * ----------------------------------------------------------------------------
 * ESP32 Remote Control with WebSocket
 * ----------------------------------------------------------------------------
 * © 2020 Stéphane Calderoni
 * ----------------------------------------------------------------------------
 */

#include <Arduino.h>

// ----------------------------------------------------------------------------
// Definition of macros
// ----------------------------------------------------------------------------

#define LED_PIN 32

// ----------------------------------------------------------------------------
// Definition of the Led component
// ----------------------------------------------------------------------------

struct Led {
    // state variables
    uint8_t pin;
    bool    on;

    // methods
    void update() {
        digitalWrite(pin, on ? HIGH : LOW);
    }
};

// ----------------------------------------------------------------------------
// Definition of global variables
// ----------------------------------------------------------------------------

Led led = { LED_PIN, false };

// ----------------------------------------------------------------------------
// Initialization
// ----------------------------------------------------------------------------

void setup() {
    pinMode(led.pin, OUTPUT);
}

// ----------------------------------------------------------------------------
// Main control loop
// ----------------------------------------------------------------------------

void loop() {
    led.on = millis() % 1000 < 50;
    led.update();
}
