armarten/hmc-cowBell-clinic/(commit log)

2023-11-10 added results
    [2023_11_09__17_09_19__100_hz__1000_n__cal.csv, 2023_11_09__17_10_36__100_hz__1000_n__cal.csv]
2023-11-10 added and deleted results
    [2023_11_09__17_09_19__100_hz__1000_n__cal.csv, 2023_11_09__17_10_36__100_hz__1000_n__cal.csv, 2023_11_09__17_58_35__100_hz__1000_n__cal.csv, 2023_11_09__17_59_04__100_hz__100_n__cal.csv, 2023_11_09__17_59_18__100_hz__1000_n__cal.csv]
2023-11-10 new data, header - to _
    [2023_11_09__17_58_35__100_hz__1000_n__cal.csv, 2023_11_09__17_59_04__100_hz__100_n__cal.csv, 2023_11_09__17_59_18__100_hz__1000_n__cal.csv, 2023_11_09__19_05_45__100_hz__1000_n__cal.csv, 2023_11_09__19_06_51__100_hz__1000_n__cal.csv, 2023_11_09__19_07_20__100_hz__1000_n__background_zeros.csv, 2023_11_09__19_10_52__100_hz__10000_n__low_range.csv, 2023_11_09__19_12_06__100_hz__10000_n__low_range.csv]
2023-11-10 matlab plot difference
    [flow_run1.csv]
2023-11-13 started butterworth filtering
2023-11-28 Added Basic Stepper Motor sketch
2023-11-29 sample rate check
    [2023_11_28__14_32_34__100_hz__10000_n__low_range.csv, 2023_11_28__14_41_56__100_hz__10000_n__low_range.csv, 2023_11_28__15_43_07__100_hz__10000_n__low_range.csv, 2023_11_28__15_44_34__100_hz__100_n__low_range.csv, 2023_11_28__15_46_04__100_hz__100_n__low_range.csv, 2023_11_28__15_48_20__100_hz__100_n__low_range.csv, 2023_11_28__15_50_05__100_hz__100_n__low_range.csv, 2023_11_28__15_50_35__100_hz_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]
2024-01-21 added some sample period plots
2024-01-21 mfc test runs
    [2024_01_21__13_25_15__100_hz__100_n__samp_rate_check.csv, 2024_01_21__13_25_45__100_hz__100_n__samp_rate_check.csv, 2024_01_21__13_26_51__100_hz__1000_n__samp_rate_check.csv, 2024_01_21__13_27_20__100_hz__10000_n__samp_rate_check.csv, 2024_01_21__13_30_23__100_hz__10000_n__samp_rate_check.csv]
2024-01-31 Updated sfm3300_read
    Added running average and made other small adjustments to Arduino code.
2024-02-06 new arduino matlab stuff
    folder for results, moved things around
    [05-Feb-2024-15-00-28_test_zeroes.csv, 05-Feb-2024-15-05-22_test_zeroes.csv, 05-Feb-2024-15-06-15_test_zeroes.csv, 05-Feb-2024-15-06-44_test_zeroes.csv, 05-Feb-2024-15-48-27_test_zeroes.csv, 05-Feb-2024-15-49-46_test_zeroes.csv, 05-Feb-2024-15-50-50_test_zeroes.csv, data.csv]
2024-02-06 rearranged files, small arduino updates
    [05-Feb-2024-15-00-28_test_zeroes.csv, 05-Feb-2024-15-05-22_test_zeroes.csv, 05-Feb-2024-15-06-15_test_zeroes.csv, 05-Feb-2024-15-06-44_test_zeroes.csv, 05-Feb-2024-15-48-27_test_zeroes.csv, 05-Feb-2024-15-49-46_test_zeroes.csv, 05-Feb-2024-15-50-50_test_zeroes.csv, 2023_11_09__17_58_35__100_hz__1000_n__cal.csv]
2024-02-06 added csv to table file/function
    [05-Feb-2024-15-06-44_test_zeroes.csv]
2024-02-06 new data and plotting matlab
    [05-Feb-2024-21-27-39_test_zeroes.csv]
2024-02-08 new data, plots
    [07-Feb-2024-13-21-54_test_zeroes.csv, 07-Feb-2024-13-23-17_test_zeroes.csv, 07-Feb-2024-13-24-22_ppp_sweep.csv]
2024-02-14 new plots and MFC comparison
    [11-Feb-2024-14-43-28_gray_valve.csv, Custom Emitter Characterization and Calibration - Comparable MFCs(1).csv, Custom Emitter Characterization and Calibration - Comparable MFCs.csv, p control 3400 2_12_2024 - Sheet 2.csv, p control 3400 2_12_2024 - Sheet 3.csv, p control 3400 2_12_2024 - Sheet 4.csv, p control 3400 2_12_2024 - Sheet 5.csv, p control 3400 2_12_2024 - Sheet 6.csv]
2024-03-25 working parallel flow and new data
    [20-Feb-2024-16-56-20_zero_test.csv, 21-Mar-2024-01-23-20_parallel_test.csv, cv_valve_characterization.csv, cv_valve_characterization1.csv, parallel_flow_test_results.csv]
2024-03-31 pattern flow
2024-04-01 Pattern flow debug, 3300 float to 0
    Big changes for pattern flow marked with "NEW1" and end at "(end new1)". Only change for 3300 float to 0 is marked with "NEW2" and ends at "(end new2)". Small changes (line 292, millis()->time_check_ms) commented // NEW1
2024-04-10 pcb files, sci50 project
    [08-Apr-2024-10-09-54_cout_vs_serial_esp32.csv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]
2024-04-13 refined V3, bug fixes
    [esp32_api_string.ino, esp32_api_therm.ino, esp32_therm.ino]
2024-04-20 PID draft
2024-04-21 printall, ><
2024-04-22 pid big
    use PID_big
    [21-Apr-2024-15-49-44_cout_vs_serial_esp32.csv, 21-Apr-2024-15-49-58_parallel_all_run.csv, 21-Apr-2024-15-58-17_parallel_all_run.csv]
2024-04-23 new data
    [21-Apr-2024-22-26-39_parallel_all_run.csv, 21-Apr-2024-22-49-24_parallel_all_run.csv, 21-Apr-2024-23-06-27_parallel_275.csv, 22-Apr-2024-16-42-40_parallel_275.csv, 22-Apr-2024-16-43-18_parallel_275.csv, inline_parallel_250SLPM.csv, inline_parallel_250SLPM_2.csv, parallel_all_run_1_mfc.csv]
2024-04-26 it works!!!
    [05-Feb-2024-15-00-28_test_zeroes.csv, 05-Feb-2024-15-05-22_test_zeroes.csv, 05-Feb-2024-15-06-15_test_zeroes.csv, 05-Feb-2024-15-06-44_test_zeroes.csv, 05-Feb-2024-15-48-27_test_zeroes.csv, 05-Feb-2024-15-49-46_test_zeroes.csv, 05-Feb-2024-15-50-50_test_zeroes.csv, 05-Feb-2024-21-27-39_test_zeroes.csv]
2024-04-26 dominick's changes
    motor speed, floating 0 handling
